kenyahiro/double-action-keyboard/case/dak_case_bottom-bottom_case.stl

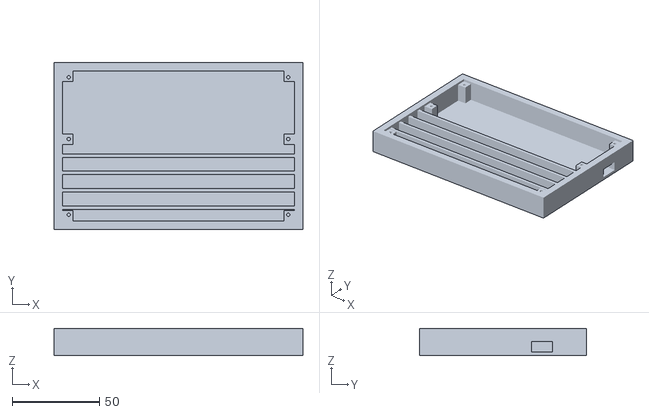
[picture p1: CAD file, 2025-02-28]
case/dak_case_bottom-bottom_case.stl
143.0 x 96.0 x 15.6
