kenyahiro/double-action-keyboard/case/dak_pixel8pro_case-Body.stl

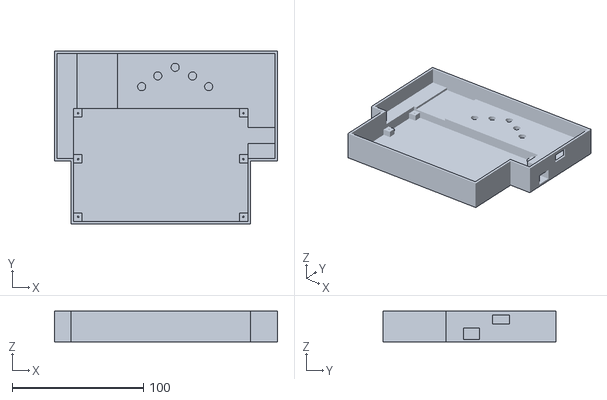
[picture p2: CAD file, 2025-02-28]
case/dak_pixel8pro_case-Body.stl
170.0 x 132.0 x 23.6
