kenyahiro/double-action-keyboard/case/dak_case_bottom-top_case.stl

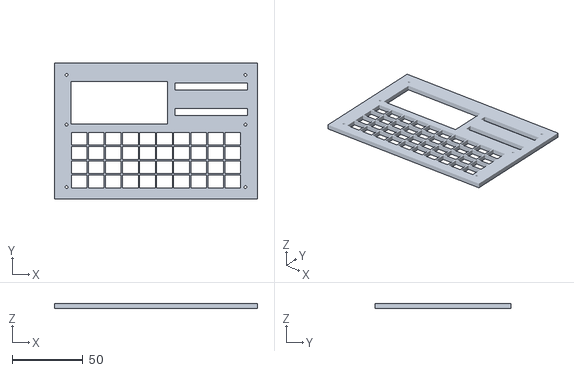
[picture p4: CAD file, 2025-02-28]
case/dak_case_bottom-top_case.stl
143.0 x 96.0 x 3.50
