kenyahiro/double-action-keyboard/case/dak_pixel8pro_case.FCStd

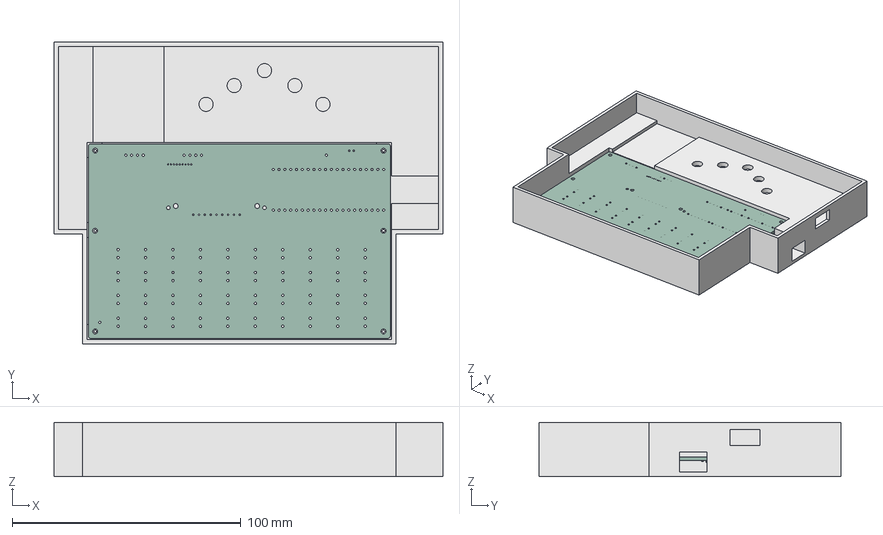
[picture p5: CAD file, 2025-02-28]
case/dak_pixel8pro_case.FCStd
170.0 x 132.0 x 23.6 mm
D_SOD_123
C_0603_1608Metric
D_SOD_124
D_SOD_125
R_0603_1608Metric
D_SOD_126
D_SOD_127
D_SOD_128
D_SOD_129
D_SOD_130
D_SOD_131
D_SOD_132
D_SOD_133
D_SOD_134
D_SOD_135
D_SOD_136
D_SOD_137
D_SOD_138
R_0603_1608Metric002
D_SOD_139
D_SOD_140
D_SOD_141
D_SOD_142
D_SOD_143
D_SOD_144
R_0603_1608Metric004
D_SOD_145
D_SOD_146
D_SOD_147
D_SOD_148
D_SOD_149
D_SOD_150
D_SOD_151
D_SOD_152
D_SOD_153
C_0603_1608Metric002
D_SOD_154
D_SOD_155
D_SOD_156
D_SOD_157
C_0603_1608Metric004
D_SOD_158
D_SOD_159
R_0603_1608Metric006
D_SOD_160
D_SOD_161
D_SOD_162
D_SOD_163
D_SOD_164
D_SOD_165
D_SOD_166
D_SOD_167
C_0603_1608Metric006
D_SOD_168
D_SOD_169
D_SOD_170
D_SOD_171
D_SOD_172
D_SOD_173
D_SOD_174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
