kenyahiro/double-action-keyboard/sch/double-action-keyboard/double-action-keyboard.pdf

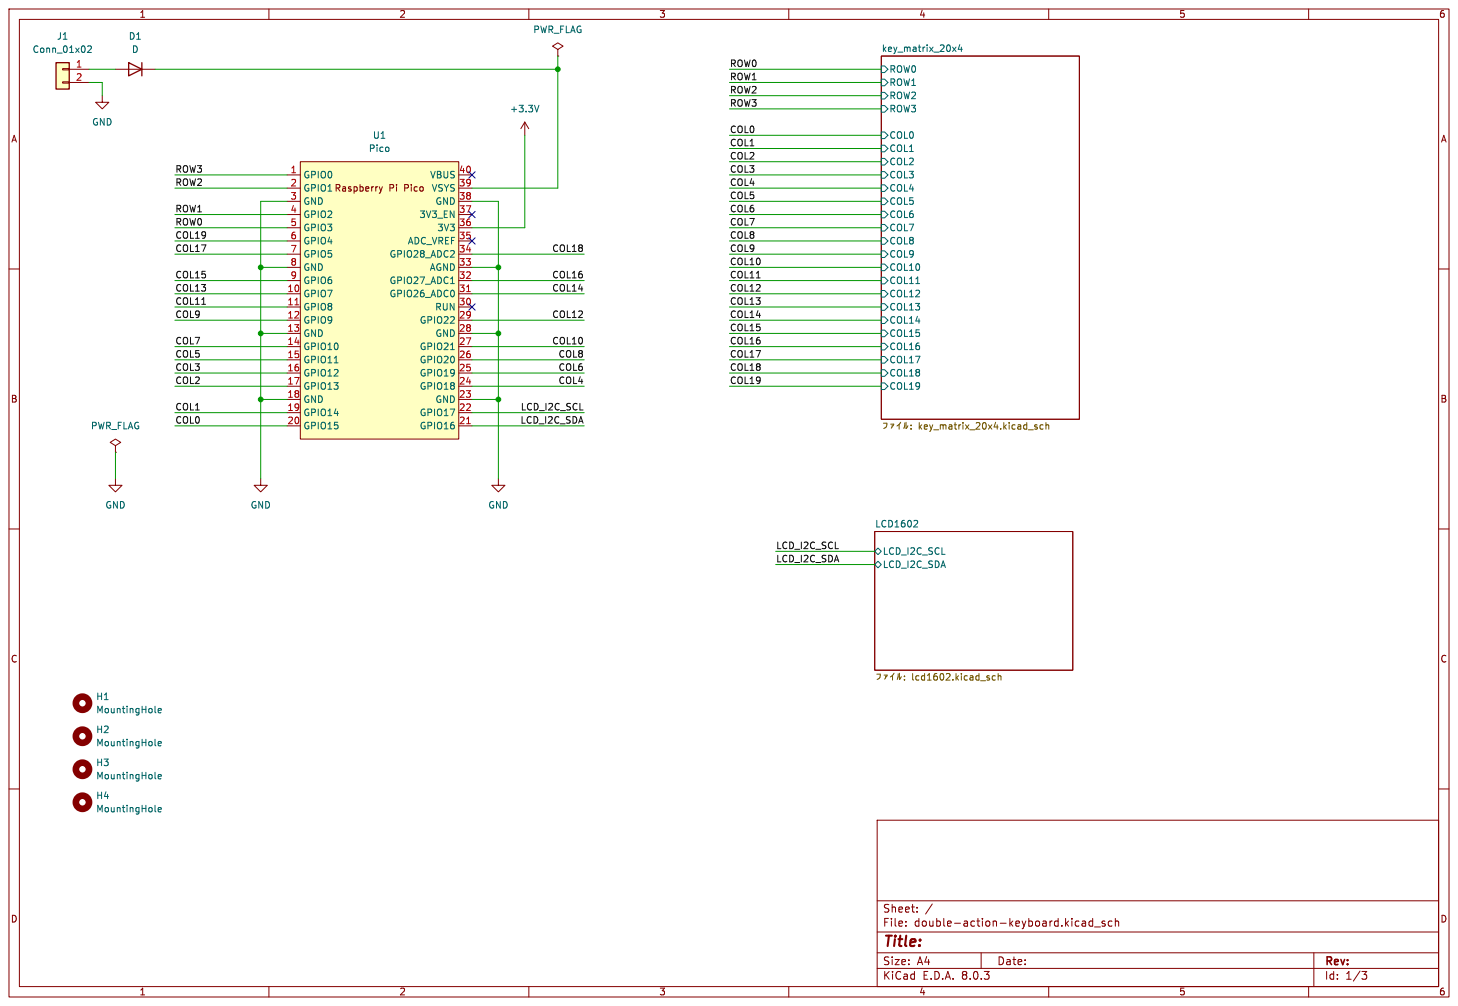
[picture p6: page 1]

Id: 1/3 Title: File: double-action-keyboard.kicad_sch Sheet: /

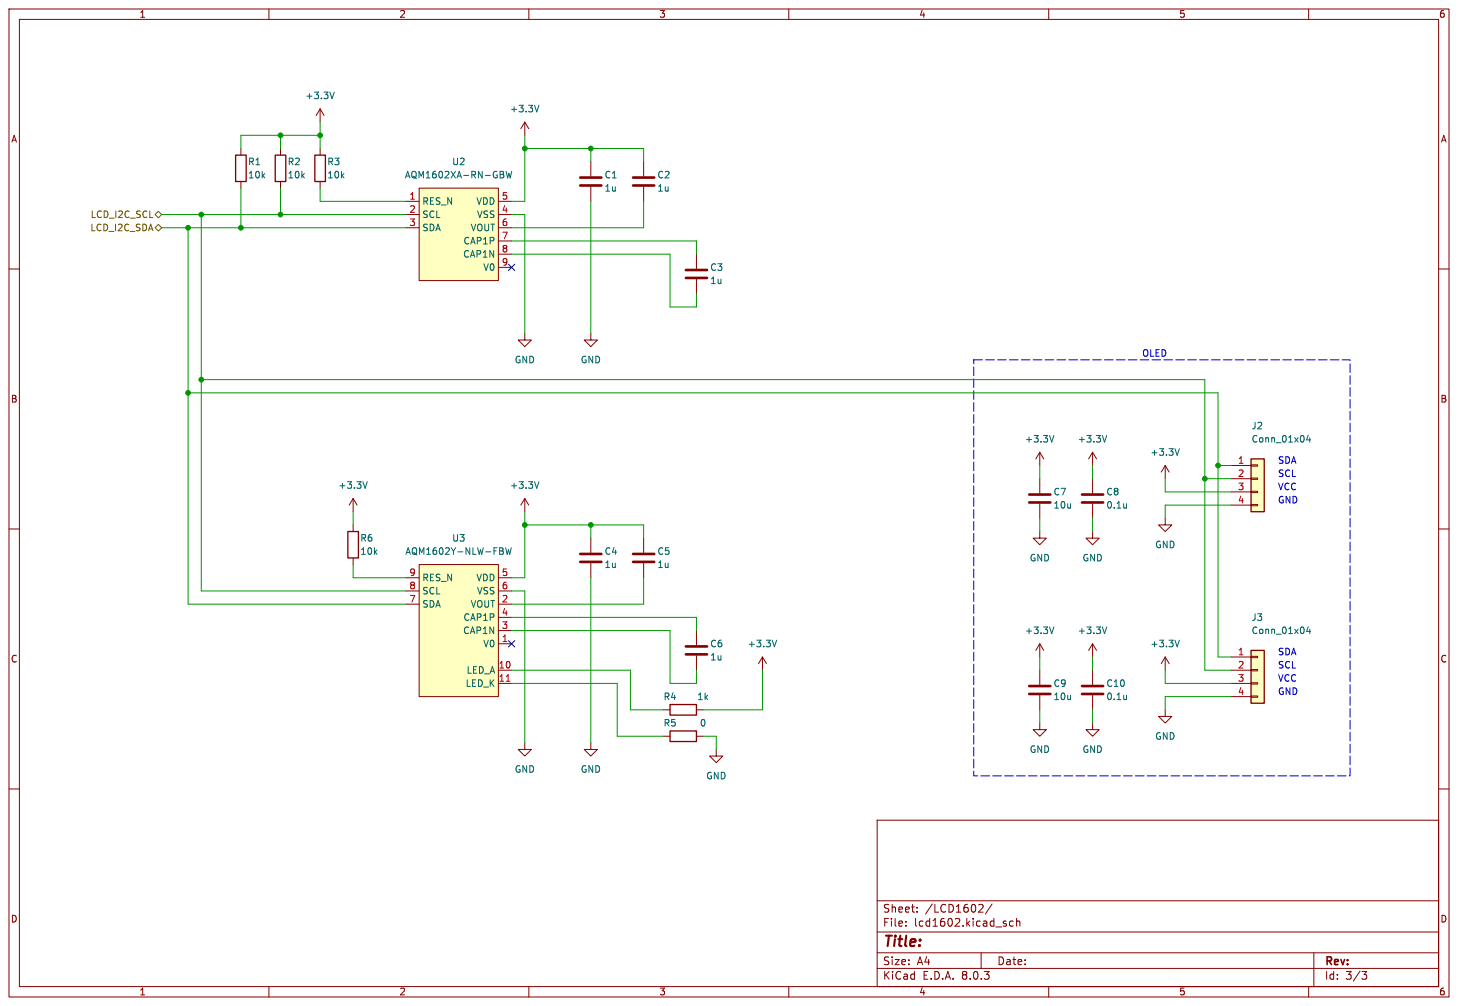
[picture p7: page 2]

Id: 3/3 Title: File: lcd1602.kicad_sch Sheet: /LCD1602/

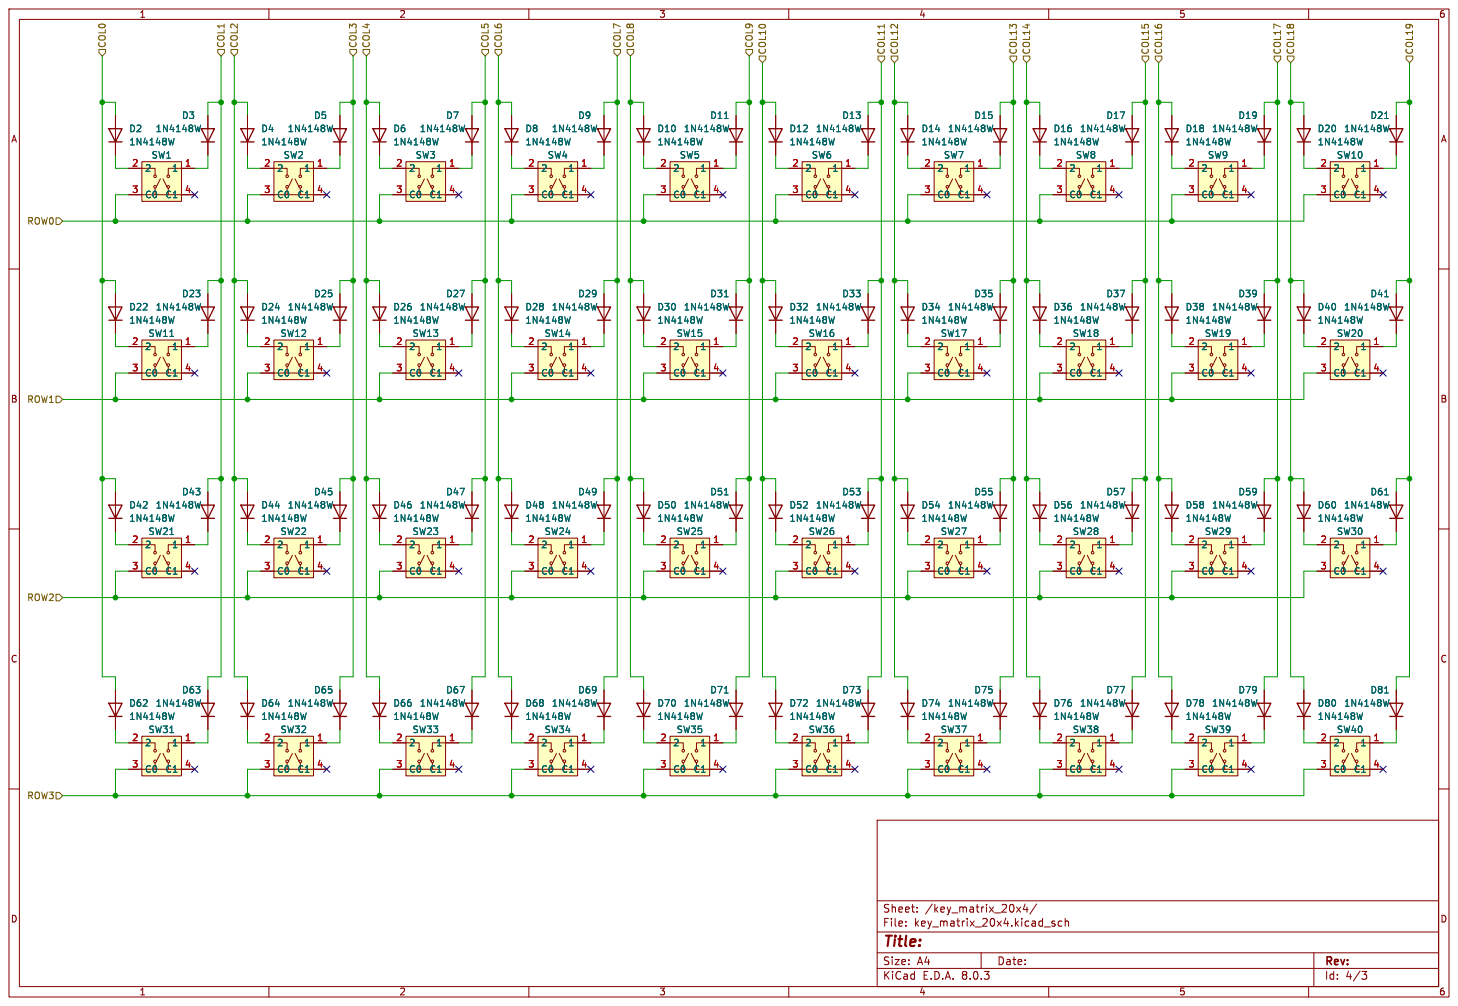
[picture p8: page 3]
