kenyahiro/double-action-keyboard/sch/double-action-keyboard/double-action-keyboard.kicad_pcb

## KiCad design sch/double-action-keyboard/double-action-keyboard.kicad_pcb (2024-07-10)

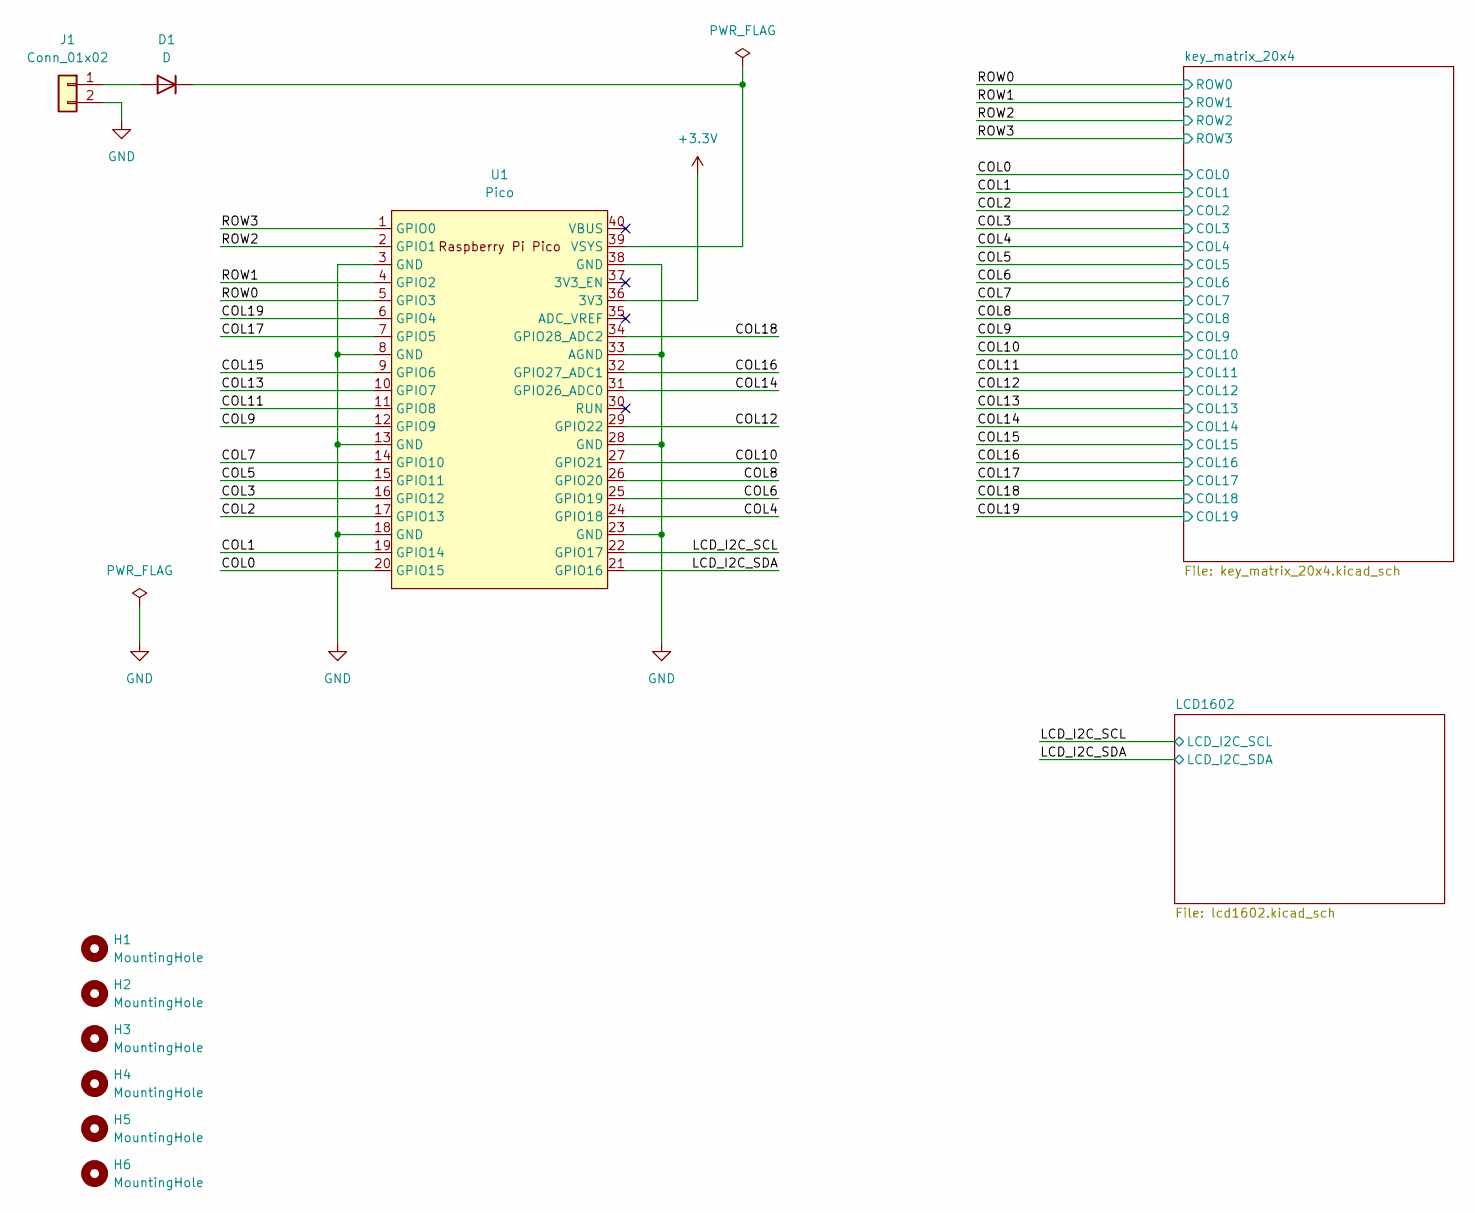
[picture p20: schematic double-action-keyboard.kicad_sch]

Parts:
D1: D; D_SOD-123
H1, H2, H3, H4, H5, H6: MountingHole; MountingHole_2.2mm_M2
J1: Conn_01x02; JST_PH_B2B-PH-K_1x02_P2.00mm_Vertical
U1: Pico; pico_no_dbg_smd_th

Connections:
+3.3V: U1.36 (3V3); also elsewhere on the board
/COL0: U1.20 (GPIO15); also elsewhere on the board
/COL1: U1.19 (GPIO14); also elsewhere on the board
/COL2: U1.17 (GPIO13); also elsewhere on the board
/COL3: U1.16 (GPIO12); also elsewhere on the board
/COL4: U1.24 (GPIO18); also elsewhere on the board
/COL5: U1.15 (GPIO11); also elsewhere on the board
/COL6: U1.25 (GPIO19); also elsewhere on the board
/COL7: U1.14 (GPIO10); also elsewhere on the board
/COL8: U1.26 (GPIO20); also elsewhere on the board
/COL9: U1.12 (GPIO9); also elsewhere on the board
/COL10: U1.27 (GPIO21); also elsewhere on the board
/COL11: U1.11 (GPIO8); also elsewhere on the board
/COL12: U1.29 (GPIO22); also elsewhere on the board
/COL13: U1.10 (GPIO7); also elsewhere on the board
/COL14: U1.31 (GPIO26_ADC0); also elsewhere on the board
/COL15: U1.9 (GPIO6); also elsewhere on the board
/COL16: U1.32 (GPIO27_ADC1); also elsewhere on the board
/COL17: U1.7 (GPIO5); also elsewhere on the board
/COL18: U1.34 (GPIO28_ADC2); also elsewhere on the board
/COL19: U1.6 (GPIO4); also elsewhere on the board
/LCD_I2C_SCL: U1.22 (GPIO17); also elsewhere on the board
/LCD_I2C_SDA: U1.21 (GPIO16); also elsewhere on the board
/ROW0: U1.5 (GPIO3); also elsewhere on the board
/ROW1: U1.4 (GPIO2); also elsewhere on the board
/ROW2: U1.2 (GPIO1); also elsewhere on the board
/ROW3: U1.1 (GPIO0); also elsewhere on the board
GND: J1.2, U1.3 (GND), U1.8 (GND), U1.13 (GND), U1.18 (GND), U1.23 (GND), U1.28 (GND), U1.33 (AGND), U1.38 (GND); also elsewhere on the board
unnamed: D1.2 (A), J1.1
unnamed: D1.1 (K), U1.39 (VSYS)

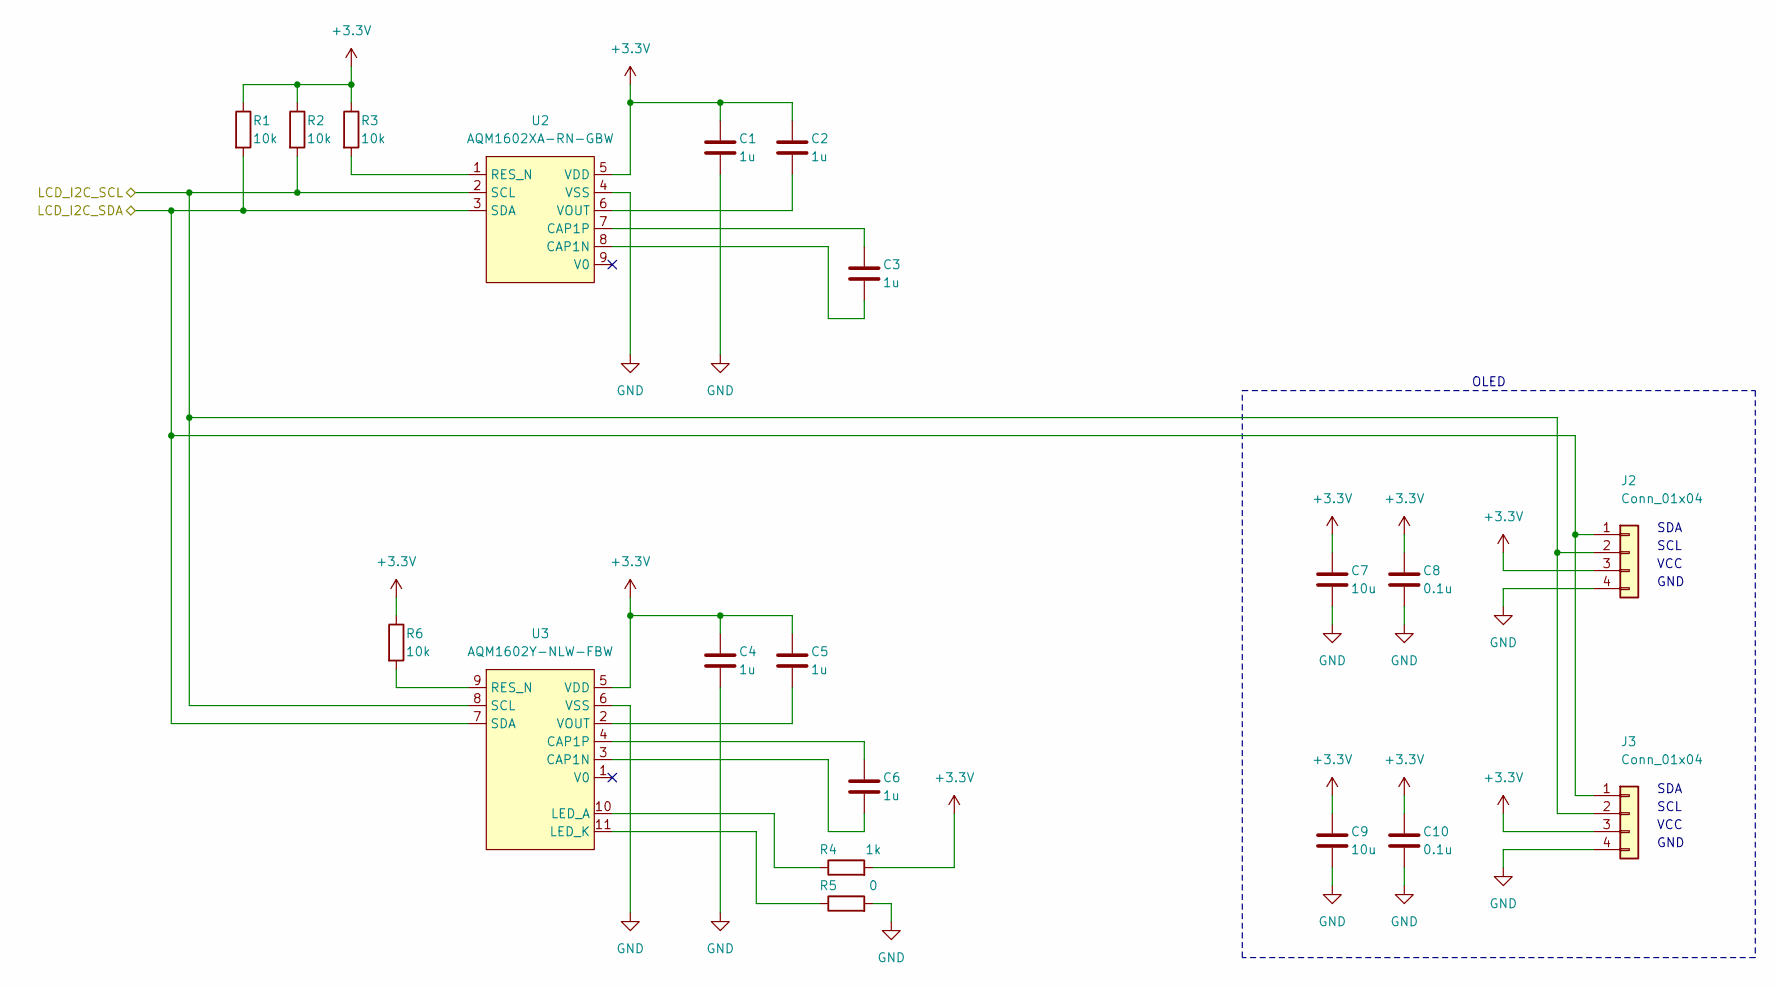
[picture p21: schematic lcd1602.kicad_sch]

Parts:
C1, C2, C3, C4, C5, C6: 1u; C_0603_1608Metric_Pad1.08x0.95mm_HandSolder
C7, C9: 10u; C_0603_1608Metric_Pad1.08x0.95mm_HandSolder
C8, C10: 0.1u; C_0603_1608Metric_Pad1.08x0.95mm_HandSolder
J2, J3: Conn_01x04; OLED_I2C
R1, R2, R3, R6: 10k; R_0603_1608Metric_Pad0.98x0.95mm_HandSolder
R4: 1k; R_0603_1608Metric_Pad0.98x0.95mm_HandSolder
R5: 0; R_0603_1608Metric_Pad0.98x0.95mm_HandSolder
U2: AQM1602XA-RN-GBW
U3: AQM1602Y-NLW-FBW

Connections:
+3.3V: C1.1, C2.1, C4.1, C5.1, C7.1, C8.1, C9.1, C10.1, J2.3, J3.3, R1.1, R2.1, R3.1, R4.2, R6.1, U2.5 (VDD), U3.5 (VDD); also elsewhere on the board
/LCD_I2C_SCL: J2.2, J3.2, R2.2, U2.2 (SCL), U3.8 (SCL); also elsewhere on the board
/LCD_I2C_SDA: J2.1, J3.1, R1.2, U2.3 (SDA), U3.7 (SDA); also elsewhere on the board
GND: C1.2, C4.2, C7.2, C8.2, C9.2, C10.2, J2.4, J3.4, R5.2, U2.4 (VSS), U3.6 (VSS); also elsewhere on the board
unnamed: C3.2, U2.8 (CAP1N)
unnamed: C3.1, U2.7 (CAP1P)
unnamed: R3.2, U2.1 (RES_N)
unnamed: C2.2, U2.6 (VOUT)
unnamed: C6.2, U3.3 (CAP1N)
unnamed: C6.1, U3.4 (CAP1P)
unnamed: R4.1, U3.10 (LED_A)
unnamed: R5.1, U3.11 (LED_K)
unnamed: R6.2, U3.9 (RES_N)
unnamed: C5.2, U3.2 (VOUT)

Notes on the sheet:
GND
SCL
VCC
SDA
OLED

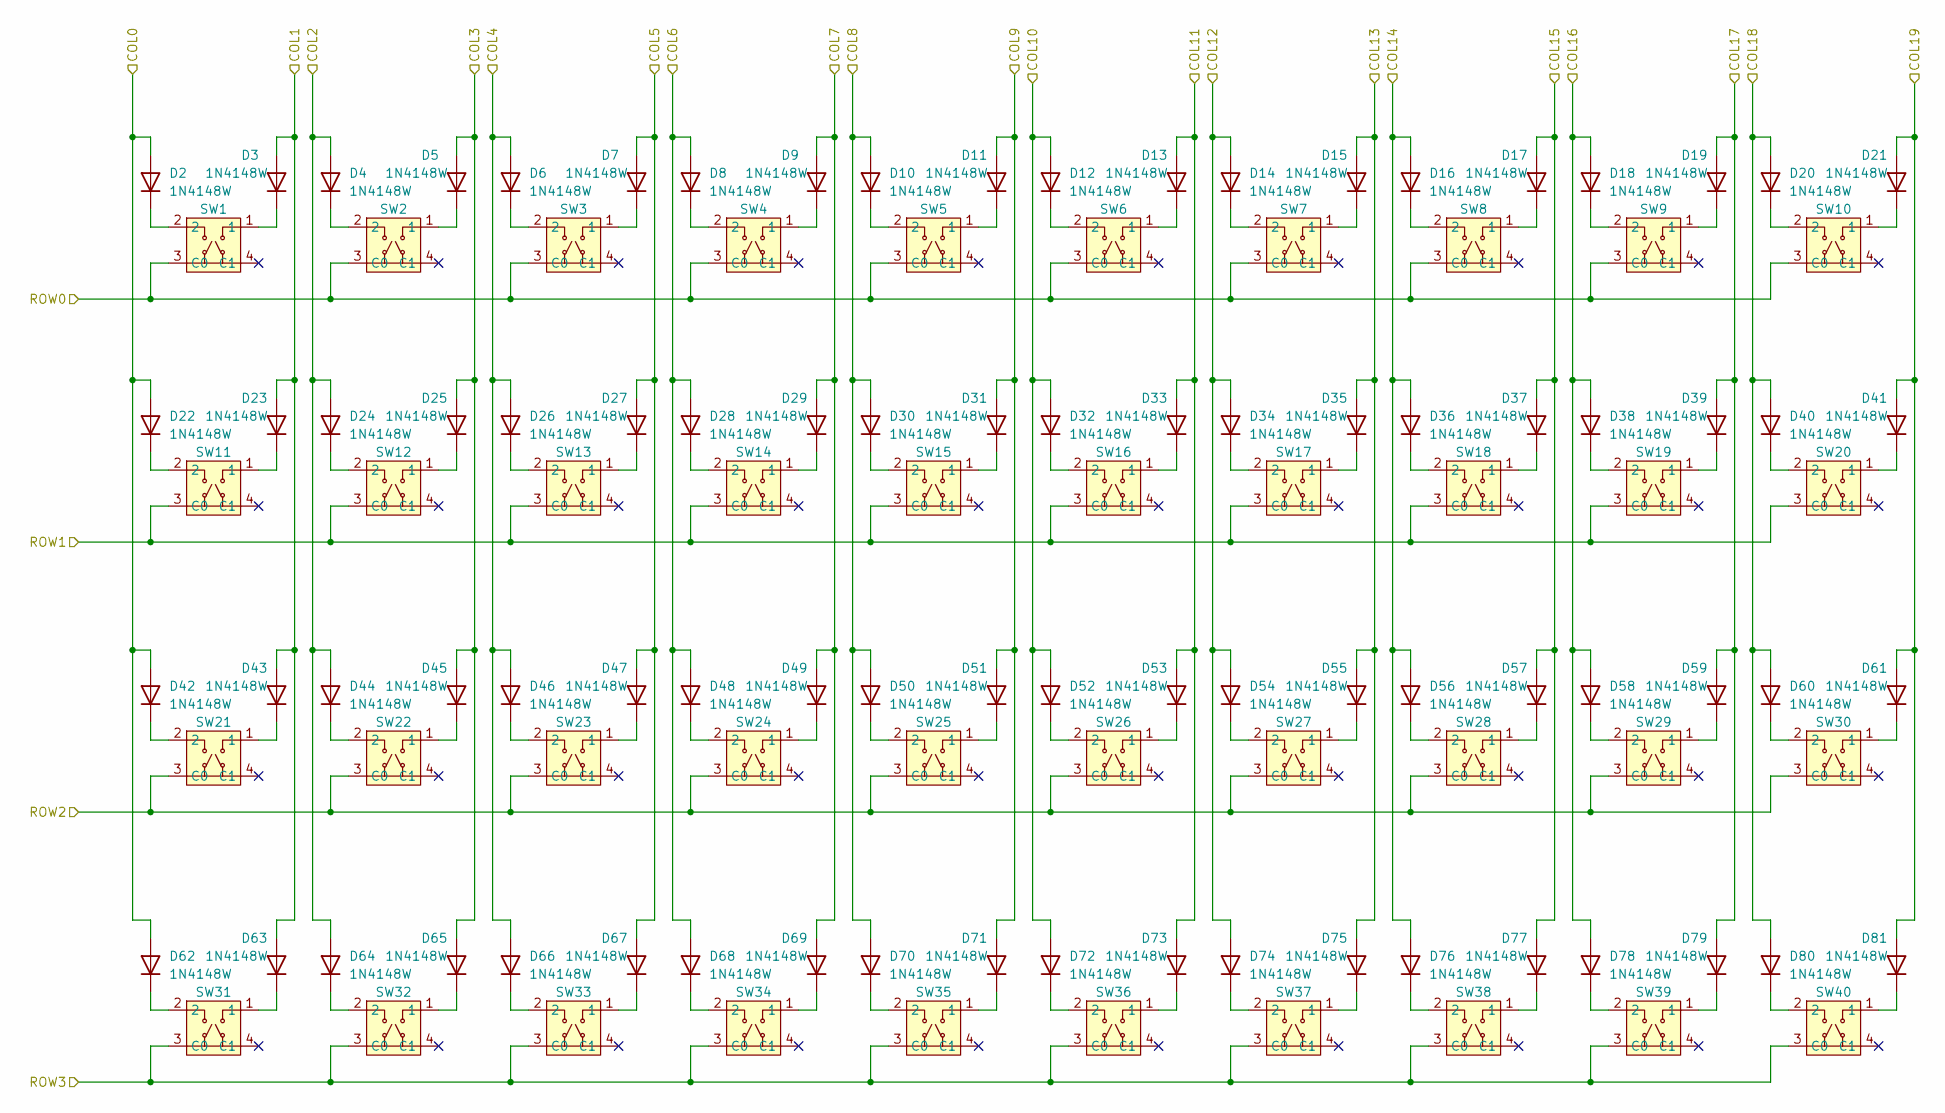
[picture p22: schematic key_matrix_20x4.kicad_sch]

Parts:
D2, D3, D4, D5, D6, D7, D8, D9, D10, D11, D12, D13, D14, D15, D16, D17, D18, D19, D20, D21, D22, D23, D24, D25, D26, D27, D28, D29, D30, D31, D32, D33, D34, D35, D36, D37, D38, D39, D40, D41, D42, D43, D44, D45, D46, D47, D48, D49, D50, D51, D52, D53, D54, D55, D56, D57, D58, D59, D60, D61, D62, D63, D64, D65, D66, D67, D68, D69, D70, D71, D72, D73, D74, D75, D76, D77, D78, D79, D80, D81: 1N4148W; D_SOD-123
SW1, SW2, SW3, SW4, SW5, SW6, SW7, SW8, SW9, SW10, SW11, SW12, SW13, SW14, SW15, SW16, SW17, SW18, SW19, SW20, SW21, SW22, SW23, SW24, SW25, SW26, SW27, SW28, SW29, SW30, SW31, SW32, SW33, SW34, SW35, SW36, SW37, SW38, SW39, SW40: NPS-102-668

Connections:
/COL0: D2.2 (A), D22.2 (A), D42.2 (A), D62.2 (A); also elsewhere on the board
/COL1: D3.2 (A), D23.2 (A), D43.2 (A), D63.2 (A); also elsewhere on the board
/COL2: D4.2 (A), D24.2 (A), D44.2 (A), D64.2 (A); also elsewhere on the board
/COL3: D5.2 (A), D25.2 (A), D45.2 (A), D65.2 (A); also elsewhere on the board
/COL4: D6.2 (A), D26.2 (A), D46.2 (A), D66.2 (A); also elsewhere on the board
/COL5: D7.2 (A), D27.2 (A), D47.2 (A), D67.2 (A); also elsewhere on the board
/COL6: D8.2 (A), D28.2 (A), D48.2 (A), D68.2 (A); also elsewhere on the board
/COL7: D9.2 (A), D29.2 (A), D49.2 (A), D69.2 (A); also elsewhere on the board
/COL8: D10.2 (A), D30.2 (A), D50.2 (A), D70.2 (A); also elsewhere on the board
/COL9: D11.2 (A), D31.2 (A), D51.2 (A), D71.2 (A); also elsewhere on the board
/COL10: D12.2 (A), D32.2 (A), D52.2 (A), D72.2 (A); also elsewhere on the board
/COL11: D13.2 (A), D33.2 (A), D53.2 (A), D73.2 (A); also elsewhere on the board
/COL12: D14.2 (A), D34.2 (A), D54.2 (A), D74.2 (A); also elsewhere on the board
/COL13: D15.2 (A), D35.2 (A), D55.2 (A), D75.2 (A); also elsewhere on the board
/COL14: D16.2 (A), D36.2 (A), D56.2 (A), D76.2 (A); also elsewhere on the board
/COL15: D17.2 (A), D37.2 (A), D57.2 (A), D77.2 (A); also elsewhere on the board
/COL16: D18.2 (A), D38.2 (A), D58.2 (A), D78.2 (A); also elsewhere on the board
/COL17: D19.2 (A), D39.2 (A), D59.2 (A), D79.2 (A); also elsewhere on the board
/COL18: D20.2 (A), D40.2 (A), D60.2 (A), D80.2 (A); also elsewhere on the board
/COL19: D21.2 (A), D41.2 (A), D61.2 (A), D81.2 (A); also elsewhere on the board
/ROW0: SW1.3 (C0), SW2.3 (C0), SW3.3 (C0), SW4.3 (C0), SW5.3 (C0), SW6.3 (C0), SW7.3 (C0), SW8.3 (C0), SW9.3 (C0), SW10.3 (C0); also elsewhere on the board
/ROW1: SW11.3 (C0), SW12.3 (C0), SW13.3 (C0), SW14.3 (C0), SW15.3 (C0), SW16.3 (C0), SW17.3 (C0), SW18.3 (C0), SW19.3 (C0), SW20.3 (C0); also elsewhere on the board
/ROW2: SW21.3 (C0), SW22.3 (C0), SW23.3 (C0), SW24.3 (C0), SW25.3 (C0), SW26.3 (C0), SW27.3 (C0), SW28.3 (C0), SW29.3 (C0), SW30.3 (C0); also elsewhere on the board
/ROW3: SW31.3 (C0), SW32.3 (C0), SW33.3 (C0), SW34.3 (C0), SW35.3 (C0), SW36.3 (C0), SW37.3 (C0), SW38.3 (C0), SW39.3 (C0), SW40.3 (C0); also elsewhere on the board
unnamed: D2.1 (K), SW1.2
unnamed: D3.1 (K), SW1.1
unnamed: D4.1 (K), SW2.2
unnamed: D5.1 (K), SW2.1
unnamed: D6.1 (K), SW3.2
unnamed: D7.1 (K), SW3.1
unnamed: D8.1 (K), SW4.2
unnamed: D9.1 (K), SW4.1
unnamed: D10.1 (K), SW5.2
unnamed: D11.1 (K), SW5.1
unnamed: D12.1 (K), SW6.2
unnamed: D13.1 (K), SW6.1
unnamed: D14.1 (K), SW7.2
unnamed: D15.1 (K), SW7.1
unnamed: D16.1 (K), SW8.2
unnamed: D17.1 (K), SW8.1
unnamed: D18.1 (K), SW9.2
unnamed: D19.1 (K), SW9.1
unnamed: D20.1 (K), SW10.2
unnamed: D21.1 (K), SW10.1
unnamed: D22.1 (K), SW11.2
unnamed: D23.1 (K), SW11.1
unnamed: D24.1 (K), SW12.2
unnamed: D25.1 (K), SW12.1
unnamed: D26.1 (K), SW13.2
unnamed: D27.1 (K), SW13.1
unnamed: D28.1 (K), SW14.2
unnamed: D29.1 (K), SW14.1
unnamed: D30.1 (K), SW15.2
unnamed: D31.1 (K), SW15.1
unnamed: D32.1 (K), SW16.2
unnamed: D33.1 (K), SW16.1
unnamed: D34.1 (K), SW17.2
unnamed: D35.1 (K), SW17.1
unnamed: D36.1 (K), SW18.2
unnamed: D37.1 (K), SW18.1
unnamed: D38.1 (K), SW19.2
unnamed: D39.1 (K), SW19.1
unnamed: D40.1 (K), SW20.2
unnamed: D41.1 (K), SW20.1
unnamed: D42.1 (K), SW21.2
unnamed: D43.1 (K), SW21.1
unnamed: D44.1 (K), SW22.2
unnamed: D45.1 (K), SW22.1
unnamed: D46.1 (K), SW23.2
unnamed: D47.1 (K), SW23.1
unnamed: D48.1 (K), SW24.2
unnamed: D49.1 (K), SW24.1
unnamed: D50.1 (K), SW25.2
unnamed: D51.1 (K), SW25.1
unnamed: D52.1 (K), SW26.2
unnamed: D53.1 (K), SW26.1
unnamed: D54.1 (K), SW27.2
unnamed: D55.1 (K), SW27.1
unnamed: D56.1 (K), SW28.2
unnamed: D57.1 (K), SW28.1
unnamed: D58.1 (K), SW29.2
unnamed: D59.1 (K), SW29.1
unnamed: D60.1 (K), SW30.2
unnamed: D61.1 (K), SW30.1
unnamed: D62.1 (K), SW31.2
unnamed: D63.1 (K), SW31.1
unnamed: D64.1 (K), SW32.2
unnamed: D65.1 (K), SW32.1
unnamed: D66.1 (K), SW33.2
unnamed: D67.1 (K), SW33.1
unnamed: D68.1 (K), SW34.2
unnamed: D69.1 (K), SW34.1
unnamed: D70.1 (K), SW35.2
unnamed: D71.1 (K), SW35.1
unnamed: D72.1 (K), SW36.2
unnamed: D73.1 (K), SW36.1
unnamed: D74.1 (K), SW37.2
unnamed: D75.1 (K), SW37.1
unnamed: D76.1 (K), SW38.2
unnamed: D77.1 (K), SW38.1
unnamed: D78.1 (K), SW39.2
unnamed: D79.1 (K), SW39.1
unnamed: D80.1 (K), SW40.2
unnamed: D81.1 (K), SW40.1

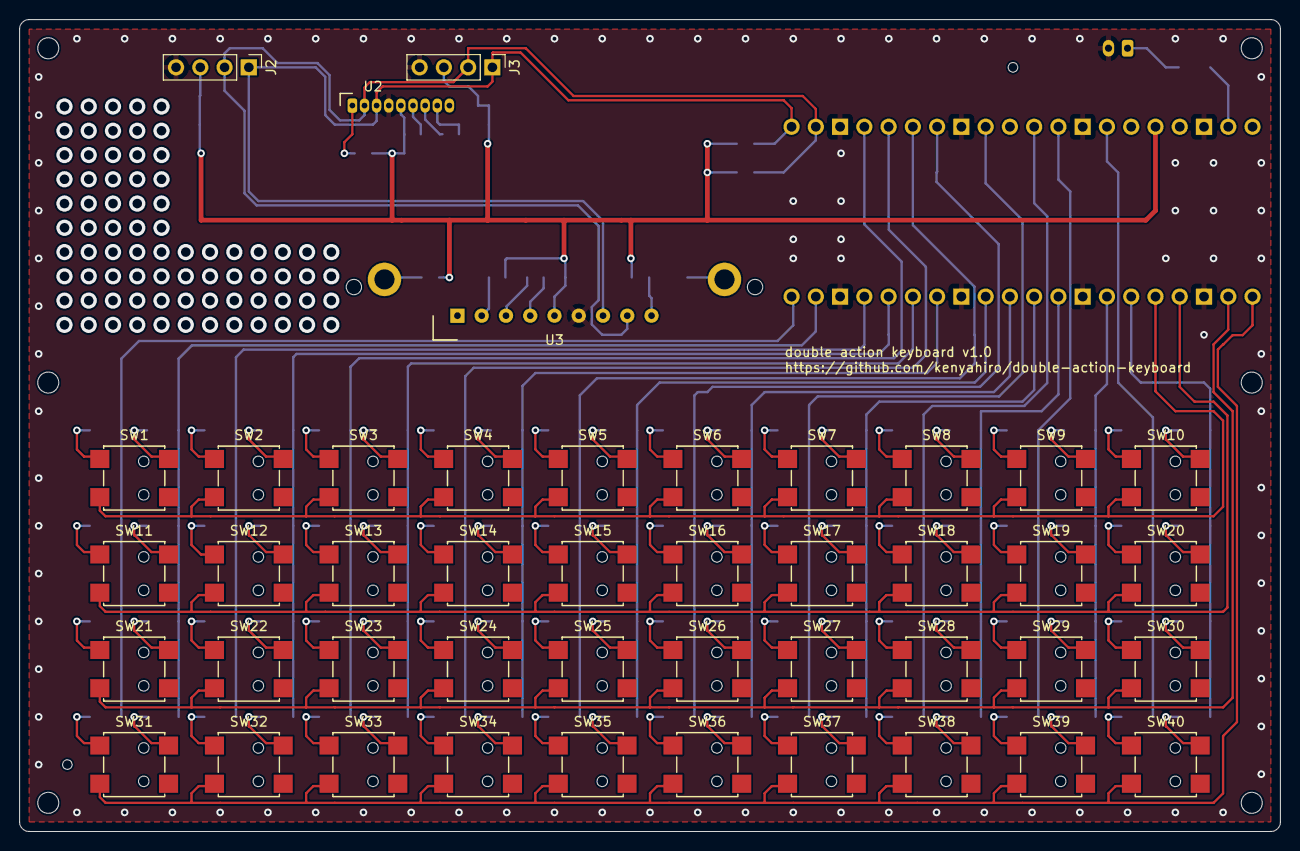
[picture p23: board double-action-keyboard.kicad_pcb from above]

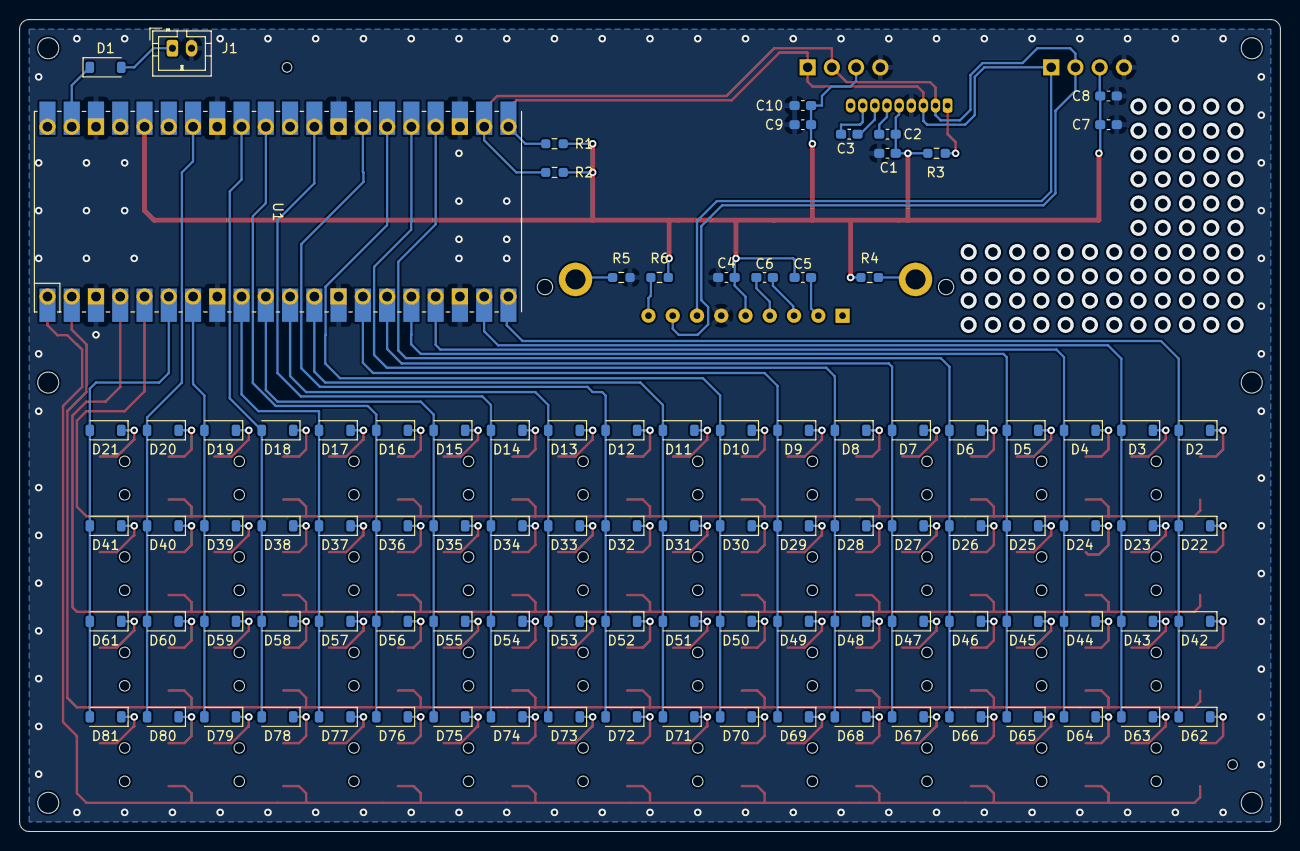
[picture p24: board double-action-keyboard.kicad_pcb from below]

Board: 2 copper layers, 132.0 x 85.0 mm, 149 parts (99 on the bottom side), 120 nets.
