kenyahiro/double-action-keyboard/(commit log)

2023-08-04 ざっくりスイッチをつなげました。
    [double-action-keyboard.kicad_pcb, double-action-keyboard.kicad_sch, key_matrix.kicad_sch]
2023-08-06 LCDを追加しました。
    [lcd1602.kicad_sch]
2023-10-10 ダイオードの配置と配線を行いました。
    [double-action-keyboard.kicad_pcb, double-action-keyboard.kicad_sch, key_matrix.kicad_sch, lcd1602.kicad_sch]
2024-06-07 KiCad 8.0にアップデートしました。 部品配置をやり直し中。
    [double-action-keyboard.kicad_pcb, double-action-keyboard.kicad_sch, key_matrix.kicad_sch, lcd1602.kicad_sch]
2024-06-07 ざっくり配線しました。 線間はもっと詰める予定。
    [double-action-keyboard.kicad_pcb, double-action-keyboard.kicad_sch, lcd1602.kicad_sch]
2024-07-01 picoの位置を右側に変更しました。
    [double-action-keyboard.kicad_pcb, double-action-keyboard.kicad_sch]
2024-07-05 LCD周りの配線を行いました。
    [key_matrix_20x4.kicad_sch]
2024-07-07 ベタGNDにビアを打ちました。 空き領域にユニバーサル領域のスルーホールを追加しました。
    [double-action-keyboard.kicad_pcb, double-action-keyboard.kicad_sch, lcd1602.kicad_sch]
2024-07-09 ステンシルの位置決め用穴を追加しました。
    [double-action-keyboard.kicad_pcb]
2024-07-09 JLCPCB DFM Toolのチェック結果を反映させました。
    [double-action-keyboard.kicad_pcb]
2024-07-10 LCD(小)とOLEDを同時に実装できるように位置を調整しました。 スイッチのランドを0.5mm大きくしました。
    [double-action-keyboard.kicad_pcb]
2024-11-14 スマホ一体型のケースです。 サイズ感を見るためのテスト出力になります。
    [dak_pixel8pro_case-Body.stl, dak_pixel8pro_case.FCStd]
2025-02-28 デバッグ時に不便なため、基板下側のケースを作ります。
    [dak_case_bottom-bottom_case.stl, dak_case_bottom-top_case.stl, dak_case_bottom.FCStd, dak_pixel8pro_case-Body.stl, dak_pixel8pro_case.FCStd]
